RabchikEngineer/ValveController/PCB/ValveController.step

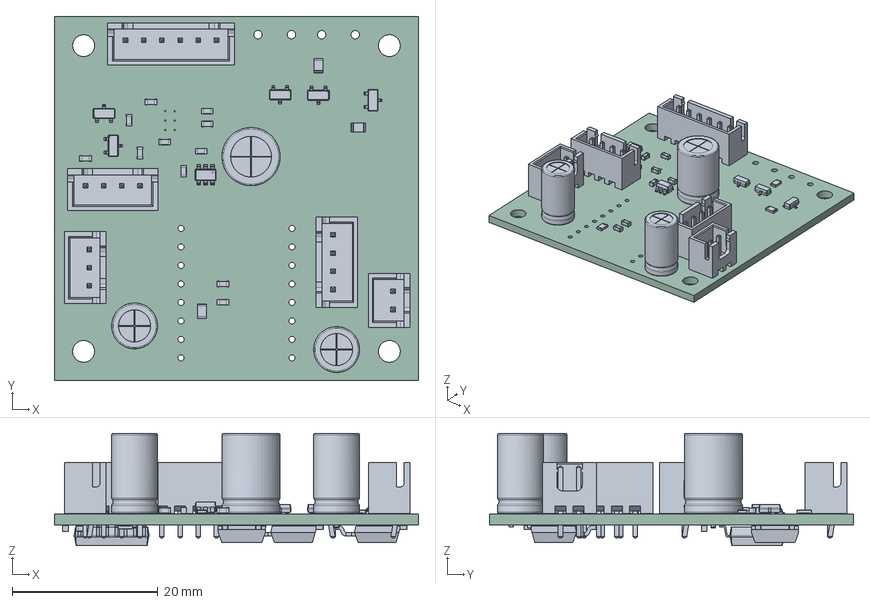
[picture p1: CAD file, 2025-12-08]
PCB/ValveController.step
50.0 x 50.0 x 15.4 mm
C_0603_1608Metric x 13
JST_XH_B4B-XH-A_1x04_P2.50mm_Vertical x 2
C_Radial_D6.3mm_H11.0mm_P2.50mm x 2
SOT-23 x 5
R_0805_2012Metric x 4
JST_XH_B3B-XH-A_1x03_P2.50mm_Vertical
C_Radial_D8.0mm_H11.5mm_P3.50mm
SOT-23-6
JST_XH_B6B-XH-A_1x06_P2.50mm_Vertical
JST_XH_B2B-XH-A_1x02_P2.50mm_Vertical
ValveController 1.29.1 x 3
SOIC-16W_7.5x10.3mm_P1.27mm
ValveController_PCB
