RabchikEngineer/ValveController/PCB/ValveController.kicad_pcb

## KiCad design PCB/ValveController.kicad_pcb (2025-12-16)

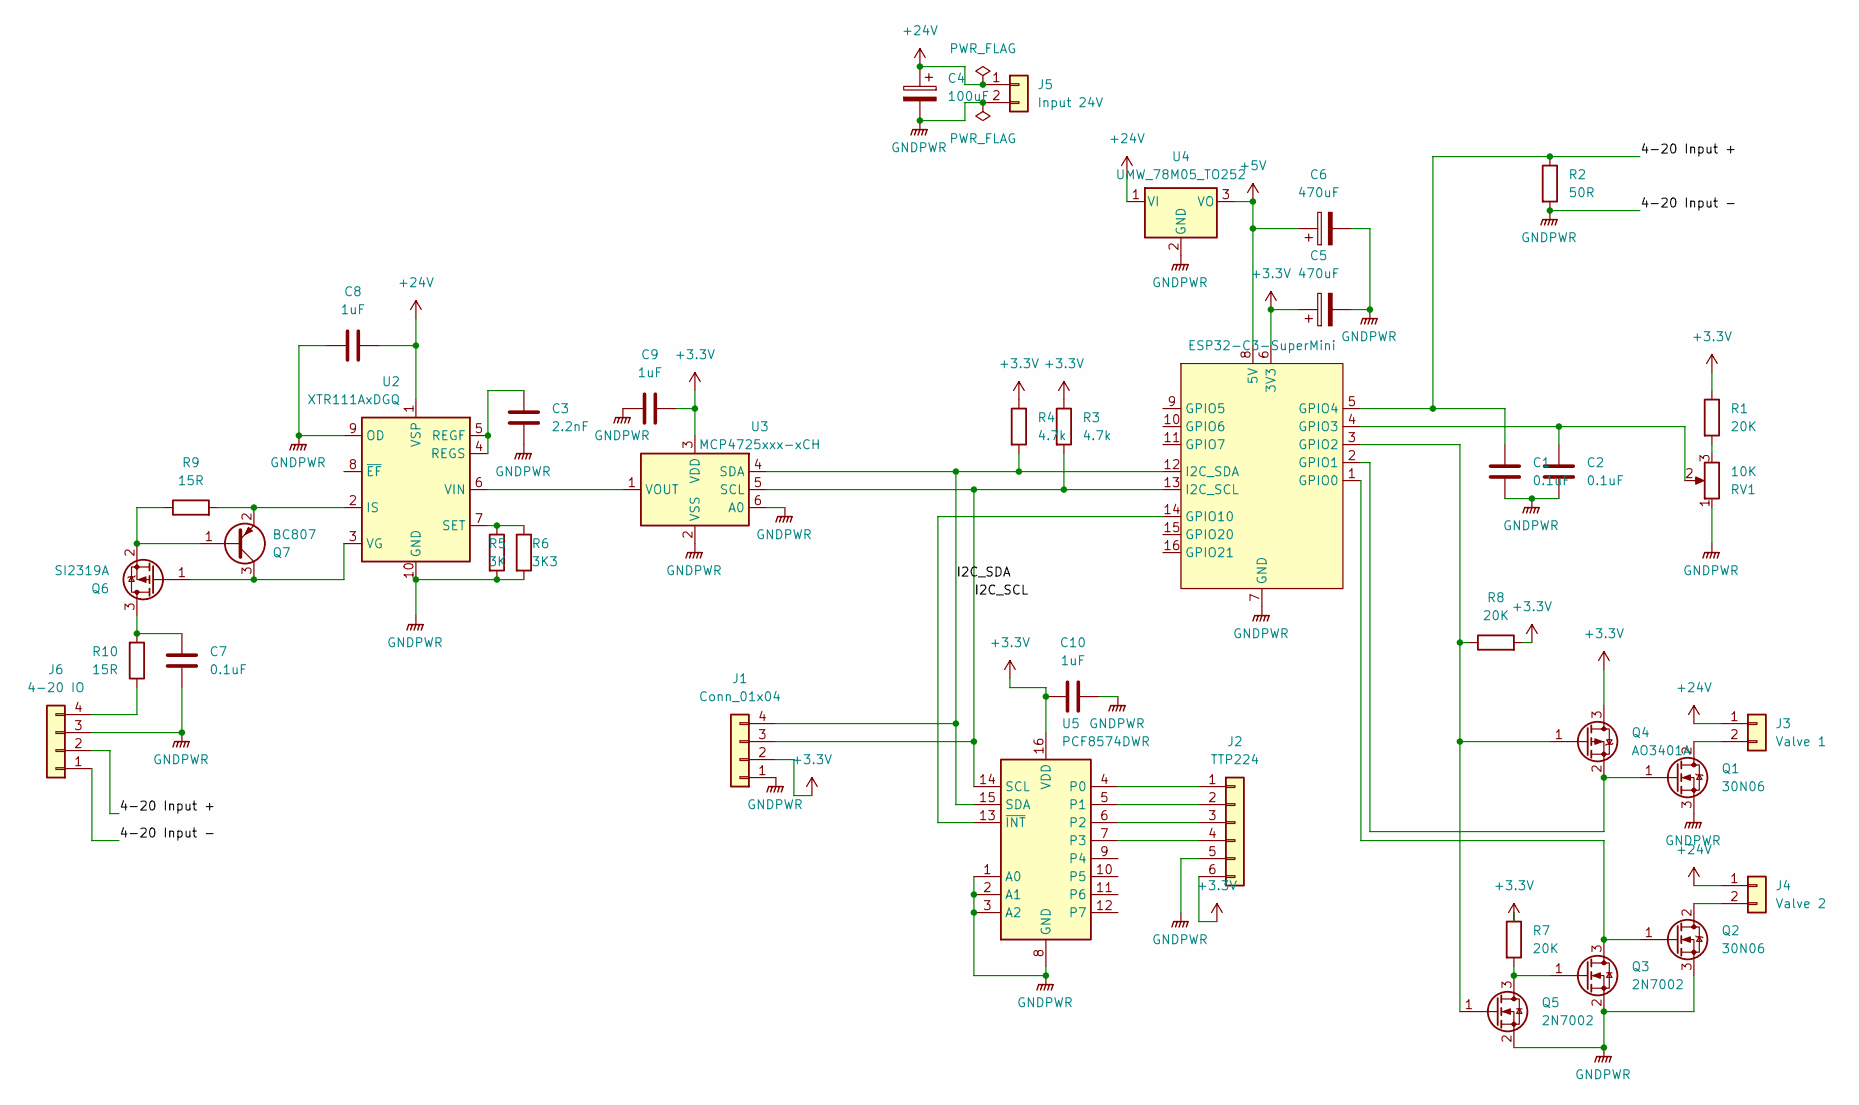
[picture p2: schematic ValveController.kicad_sch]

Parts:
C1, C2, C7: 0.1uF; C_0603_1608Metric_Pad1.08x0.95mm_HandSolder
C3: 2.2nF; C_0603_1608Metric_Pad1.08x0.95mm_HandSolder
C4: 100uF; C_Radial_D8.0mm_H11.5mm_P3.50mm
C5, C6: 470uF; C_Radial_D6.3mm_H11.0mm_P2.50mm
C8, C9, C10: 1uF; C_0603_1608Metric_Pad1.08x0.95mm_HandSolder
J1: Conn_01x04; JST_XH_B4B-XH-A_1x04_P2.50mm_Vertical
J2: TTP224; JST_XH_B6B-XH-A_1x06_P2.50mm_Vertical
J3: Valve 1; SolderWire-0.5sqmm_1x02_P4.6mm_D0.9mm_OD2.1mm
J4: Valve 2; SolderWire-0.5sqmm_1x02_P4.6mm_D0.9mm_OD2.1mm
J5: Input 24V; JST_XH_B2B-XH-A_1x02_P2.50mm_Vertical
J6: 4-20 IO; JST_XH_B4B-XH-A_1x04_P2.50mm_Vertical
Q1, Q2: 30N06; TO-252-2
Q3, Q5: 2N7002; SOT-23
Q4: AO3401A; SOT-23
Q6: SI2319A; SOT-23
Q7: BC807; SOT-23
R1, R7, R8: 20K; R_0805_2012Metric_Pad1.20x1.40mm_HandSolder
R2: 50R; R_0805_2012Metric_Pad1.20x1.40mm_HandSolder
R3, R4: 4.7k; C_0603_1608Metric_Pad1.08x0.95mm_HandSolder
R5: 3K; C_0603_1608Metric_Pad1.08x0.95mm_HandSolder
R6: 3K3; C_0603_1608Metric_Pad1.08x0.95mm_HandSolder
R9, R10: 15R; C_0603_1608Metric_Pad1.08x0.95mm_HandSolder
RV1: 10K; SolderWire-0.5sqmm_1x03_P4.6mm_D0.9mm_OD2.1mm
U1: ESP32-C3-SuperMini
U2: XTR111AxDGQ; MSOP-10-1EP_3x3mm_P0.5mm_EP2.2x3.1mm_Mask1.83x1.89mm_Therma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
U3: MCP4725xxx-xCH; SOT-23-6
U4: UMW_78M05_TO252; TO-252-2
U5: PCF8574DWR; SOIC-16W_7.5x10.3mm_P1.27mm

Connections:
+3.3V: C5.1, C9.2, C10.1, J1.2, J2.6, Q4.3 (D), R1.1, R3.1, R4.1, R7.1, R8.2, U1.6 (3V3), U3.3 (VDD), U5.16 (VDD)
+5V: C6.1, U1.8 (5V), U4.3 (VO)
+24V: C4.1, C8.2, J3.1, J4.1, J5.1, U2.1 (VSP), U4.1 (VI)
/4-20 Input +: C1.1, J6.2, R2.1, U1.5 (GPIO4)
/I2C_SCL: J1.3, R3.2, U1.13 (I2C_SCL), U3.5 (SCL), U5.14 (SCL)
/I2C_SDA: J1.4, R4.2, U1.12 (I2C_SDA), U3.4 (SDA), U5.15 (SDA)
GNDPWR: C1.2, C2.2, C3.2, C4.2, C5.2, C6.2, C7.2, C8.1, C9.1, C10.2, J1.1, J2.5, J5.2, J6.1, J6.3, Q1.3 (S), Q2.3 (S), Q3.2 (S), Q5.2 (S), R2.2, R5.2, R6.2, RV1.1, U1.7 (GND), U2.9 (OD), U2.10 (GND), U2.11 (GND), U3.2 (VSS), U3.6 (A0), U4.2 (GND), U5.1 (A0), U5.2 (A1), U5.3 (A2), U5.8 (GND)
unnamed: J2.1, U5.4 (P0)
unnamed: J2.2, U5.5 (P1)
unnamed: J2.3, U5.6 (P2)
unnamed: J2.4, U5.7 (P3)
unnamed: J3.2, Q1.2 (D)
unnamed: J4.2, Q2.2 (D)
unnamed: J6.4, R10.1
unnamed: Q1.1 (G), Q4.2 (S), U1.2 (GPIO1)
unnamed: Q2.1 (G), Q3.3 (D), U1.1 (GPIO0)
unnamed: Q3.1 (G), Q5.3 (D), R7.2
unnamed: Q4.1 (G), Q5.1 (G), R8.1, U1.3 (GPIO2)
unnamed: C7.1, Q6.3 (D), R10.2
unnamed: Q6.1 (G), Q7.3 (C), U2.3 (VG)
unnamed: Q6.2 (S), Q7.1 (B), R9.1
unnamed: Q7.2 (E), R9.2, U2.2 (IS)
unnamed: R1.2, RV1.3
unnamed: C2.1, RV1.2, U1.4 (GPIO3)
unnamed: U1.14 (GPIO10), U5.13 (~INT)
unnamed: C3.1, U2.4 (REGS), U2.5 (REGF)
unnamed: R5.1, R6.1, U2.7 (SET)
unnamed: U2.6 (VIN), U3.1 (VOUT)

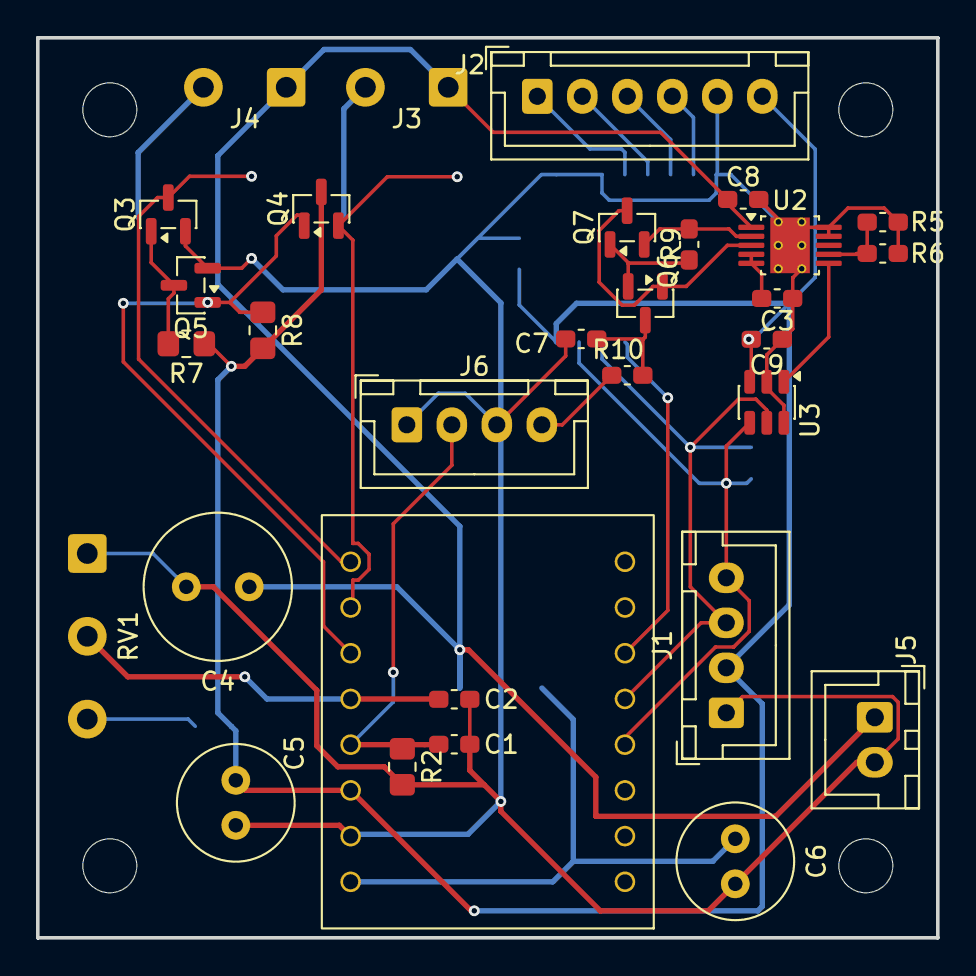
[picture p3: board ValveController.kicad_pcb from above]

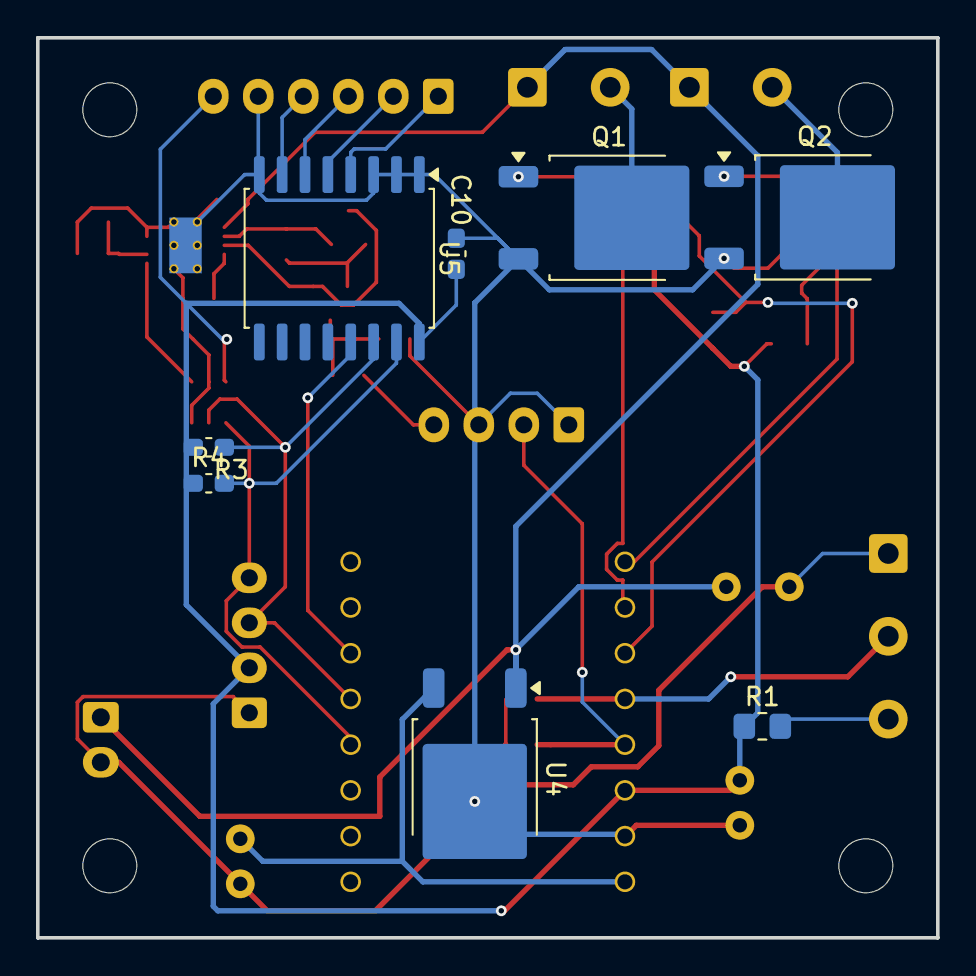
[picture p4: board ValveController.kicad_pcb from below]

Board: 2 copper layers, 50.0 x 50.0 mm, 39 parts (8 on the bottom side), 28 nets.
