RabchikEngineer/ValveController/ValveController_firmware/src/main.c

#include "esp_log.h"
#include "esp_timer.h"
#include "nvs_flash.h"
#include "cJSON.h"
#include "math.h"

//for serial communication
#include <stdio.h>
#include <string.h>

#include "freertos/FreeRTOS.h"
#include "freertos/task.h"
#include "freertos/queue.h"

#include "driver/gpio.h"
#include "driver/ledc.h"
#include "driver/i2c_master.h"
#include "driver/usb_serial_jtag.h"
#include "esp_lcd_panel_ops.h"
#include "esp_lcd_panel_io.h"
#include "esp_lcd_panel_vendor.h"


#include "config.h"
#include "adc.h"
#include "dac.h"
#include "usb_comm.h"
#include "params.h"
#include "buttons.h"
#include "ui.h"
#include "calibration.h"


const char *TAG_PID = "PID System";
const char *TAG_INPUT = "Input Handler";
const char *TAG_VALVE = "Valve Switcher";
const char *TAG_PWM = "PWM System";
// const char *TAG_ADC = "ADC";
static const char *TAG = "Main Thread";


typedef struct {
    float frequency;
    int resolution; 
} PWMConfig_t;

typedef struct {
    i2c_master_bus_handle_t bus;
    i2c_master_dev_handle_t pcf;
    i2c_master_dev_handle_t dac;
    esp_lcd_panel_handle_t  panel;
    esp_lcd_panel_io_handle_t panel_io;
} i2c_periphery_t;


QueueHandle_t inputQueue;
QueueHandle_t output_queue;


static i2c_periphery_t i2c_periphery;

static TaskHandle_t s_polling_task_handle;


volatile float valve_activation_threshold = 0.2; //for -1 --- 1 pid output



PWMConfig_t pwm_10_hz_config = {
    .frequency = 10,
    .resolution = 14
};

PWMConfig_t pwm_5_hz_config = {
    .frequency = 5,
    .resolution = 14
};

PWMConfig_t pwm_2_hz_config = {
    .frequency = 2,
    .resolution = 14
};

PWMConfig_t pwm_config;




void i2c_bus_init(i2c_master_bus_handle_t* bus)
{
     i2c_master_bus_config_t bus_cfg = {
        .i2c_port = I2C_PORT,
        .sda_io_num = I2C_SDA_GPIO,
        .scl_io_num = I2C_SCL_GPIO,
        .clk_source = I2C_CLK_SRC_DEFAULT,
        .glitch_ignore_cnt = 7,
        .flags.enable_internal_pullup = true, 
    };

    ESP_ERROR_CHECK(i2c_new_master_bus(&bus_cfg, bus));
    ESP_LOGI(TAG, "I2C bus init completed");
}

void i2c_bus_destroy(i2c_master_bus_handle_t bus)
{
    if (!bus) return;
    ESP_ERROR_CHECK(i2c_del_master_bus((i2c_master_bus_handle_t)bus));
    free(bus);
}

// void i2c_bus_remove_device(i2c_master_bus_handle_t bus, void *dev)
// {
//     (void)bus;
//     if (!dev) return;
//     ESP_ERROR_CHECK(i2c_master_bus_rm_device((i2c_master_dev_handle_t)dev));
// }

// int i2c_bus_probe(i2c_master_bus_handle_t bus, uint16_t addr_7bit, int timeout_ms)
// {
//     if (!bus) return -1;
//     return i2c_master_probe(bus, addr_7bit, timeout_ms);
// }


void i2c_periphery_init(i2c_periphery_t* i2c_periphery) {

    i2c_device_config_t dac_dev_cfg = {
        .dev_addr_length = I2C_ADDR_BIT_LEN_7,
        .device_address = MCP4725_I2C_ADDR,
        .scl_speed_hz = I2C_FREQ_HZ,
    };
    ESP_ERROR_CHECK(i2c_master_bus_add_device(i2c_periphery->bus, &dac_dev_cfg, &i2c_periphery->dac));


    i2c_device_config_t pcf_cfg = {
        .dev_addr_length = I2C_ADDR_BIT_LEN_7,
        .device_address = PCF8574DWR_I2C_ADDR,
        .scl_speed_hz = I2C_FREQ_HZ,
    };
    ESP_ERROR_CHECK(i2c_master_bus_add_device(i2c_periphery->bus, &pcf_cfg, &i2c_periphery->pcf));


    esp_lcd_panel_io_i2c_config_t panel_io_cfg = {
        .dev_addr = OLED_I2C_ADDR,
        .scl_speed_hz = I2C_FREQ_HZ,
        .control_phase_bytes = 1,
        .dc_bit_offset = 6,
        .lcd_cmd_bits = 8,
        .lcd_param_bits = 8,
    };
    ESP_ERROR_CHECK(esp_lcd_new_panel_io_i2c(i2c_periphery->bus, &panel_io_cfg, &i2c_periphery->panel_io));


    esp_lcd_panel_dev_config_t panel_cfg = {
        .bits_per_pixel = 1,
        .reset_gpio_num = OLED_RST_GPIO,
    };
    ESP_ERROR_CHECK(esp_lcd_new_panel_ssd1306(i2c_periphery->panel_io, &panel_cfg, &i2c_periphery->panel));


}






void valve_pwm_init(PWMConfig_t* config) {
    // Configure timer
    ledc_timer_config_t ledc_timer = {
        .speed_mode       = LEDC_LOW_SPEED_MODE,
        .duty_resolution  = config->resolution,
        .timer_num        = PWM_TIMER,
        .freq_hz          = config->frequency,
        .clk_cfg          = LEDC_USE_RC_FAST_CLK
    };
    ESP_ERROR_CHECK(ledc_timer_config(&ledc_timer));

    // Configure channel for INCREASE valve
    ledc_channel_config_t ledc_channel_inc = {
        .gpio_num       = VALVE_INC_PIN,
        .speed_mode     = LEDC_LOW_SPEED_MODE,
        .channel        = PWM_CHANNEL_INC,
        .intr_type      = LEDC_INTR_DISABLE,
        .timer_sel      = PWM_TIMER,
        .duty           = 0,  // Start at 0%
        .hpoint         = 0
    };
    ESP_ERROR_CHECK(ledc_channel_config(&ledc_channel_inc));

    ledc_channel_config_t ledc_channel_dec = {
        .gpio_num       = VALVE_DEC_PIN,
        .speed_mode     = LEDC_LOW_SPEED_MODE,
        .channel        = PWM_CHANNEL_DEC,
        .intr_type      = LEDC_INTR_DISABLE,
        .timer_sel      = PWM_TIMER,
        .duty           = 1,  // Start at 100%
        .hpoint         = 0
    };

    ESP_ERROR_CHECK(ledc_channel_config(&ledc_channel_dec));

    ESP_LOGI(TAG_VALVE, "PWM initialized: %d Hz, %d-bit resolution", 
             PWM_FREQUENCY, PWM_RESOLUTION);
}




void suspend_polling() {
    vTaskSuspend(s_polling_task_handle);
    ESP_LOGI(TAG, "Suspended polling task");
}

void resume_polling() {
    vTaskResume(s_polling_task_handle);
    ESP_LOGI(TAG, "Resumed polling task");
}


void polling_task() {
    ValvePositionData_t data;
    // TickType_t last_wake_time = xTaskGetTickCount();
    cl_set_output cl_val;
    while (1) {

        data = get_calibrated_adc_values();

        
        if (data.actualPositionPercent>1) {data.actualPositionPercent=1;}
        if (data.actualPositionPercent<0) {data.actualPositionPercent=0;}
        if (data.desiredPositionPercent>1) {data.desiredPositionPercent=1;}
        if (data.desiredPositionPercent<0) {data.desiredPositionPercent=0;}

        // data.desiredPositionPercent=(data.desiredPositionPercent-705)/(3590-705);
        // data.actualPositionPercent=(data.actualPositionPercent-1560)/(2480-1560);

        // Send to PID task
        xQueueSend(inputQueue, &data, 100);
        cl_val=(cl_set_output){.value=data.actualPositionPercent, .is_raw=false};
        xQueueSend(current_loop_queue, &cl_val, 100);

        // ESP_LOGI(TAG,"%d",(uint16_t)(data.actualPositionPercent*(1<<12)));
        // ESP_LOGI(TAG,"%d",((uint16_t)(data.actualPositionPercent*(1<<12)) & 0x0FFF));

        // ESP_LOGI(TAG, "Polled successfully");
        // xTaskDelayUntil(&last_wake_time,polling_delay); 
        vTaskDelay(pdMS_TO_TICKS(POLLING_DELAY));
    }
}



void PID_task() {
    ValvePositionData_t receivedData;
    
    float error = 0;
    float pid_output = 0;
    float integral = 0.0f;
    float prev_error = 0.0f;
    float dt=0.1f;
    int64_t last_time=0;
    float derivaitve_ema_alpha=0.8;
    float derivative = 0;

    // float Kp = 0.004f;
    // float Ki = 0.001f; // работают но с перелётом
    // float Kd = 0.002f;

    // float Kp = 2.0;
    // float Ki = 1.0;
    // float Kd = 2.0;

    while (1) {
        if (xQueueReceive(inputQueue, &receivedData, portMAX_DELAY) == pdPASS) {

            // controlOutput = PID_Compute(&pid, receivedData.desiredPositionPercent, receivedData.actualPositionPercent);
            error = receivedData.desiredPositionPercent - receivedData.actualPositionPercent;

            int64_t current_time = esp_timer_get_time();
            dt = (current_time - last_time) / 1000000.0f; // calculating actual dt. however it might differs only for 1%
            last_time=current_time;

            derivative = (derivative * (1- derivaitve_ema_alpha)) + ( (error - prev_error) / dt)*derivaitve_ema_alpha;
            prev_error = error;

            pid_output = ((g_config.kp * error) + (g_config.ki * integral) + (g_config.kd * derivative));

            bool saturated = (pid_output > 1.0f) || (pid_output < -1.0f);
            bool in_dead_zone = (fabsf(error) < g_config.deadzone); // doesnt calculate integral in small zone
            // Only integrate if not saturated
            if (!saturated && !in_dead_zone) {
                integral += error * dt;
                if (integral > 1.0f) integral = 1.0f; 
                if (integral < -1.0f) integral = -1.0f;
            } else if (saturated){
                // Decay integral slowly when can't actuate
                integral *= 0.95f;
            } else if (in_dead_zone){
                integral = 0;
                // pid_output=0;
            }

            if (isnan(pid_output)) {
                integral=0;
            }

            if (receivedData.desiredPositionPercent<0.01f) {
                pid_output=-1.0f;
            }
            if (receivedData.desiredPositionPercent>0.99f) {
                pid_output=1.0f;
            }


            // Convert controlOutput to command for valves
            // ESP_LOGI(TAG_PID, "Params P: %0.2f, I: %0.2f, D: %0.2f", g_config.kp, g_config.ki, g_config.kd);
            ESP_LOGI(TAG_PID, "A: %.3f/D: %.3f,I: %.3f , dt: %.5f, %.4f", 
                     receivedData.actualPositionPercent, receivedData.desiredPositionPercent, integral, dt, pid_output);
            // pid_output=0;
            xQueueSend(output_queue, &pid_output, 100);
        }
    }
}


void set_valve_pwm_task() {
    
    uint32_t max_duty = (1 << PWM_RESOLUTION) - 1;  // 1023 for 10-bit
    uint32_t duty_inc = 0;
    uint32_t duty_dec = 0;

    // TickType_t disabled_until = 0;

    float pid_output=0;
    
    while (1) {
        if (xQueueReceive(output_queue, &pid_output, portMAX_DELAY) == pdPASS) {


            if (fabsf(pid_output)<valve_activation_threshold) { // dead zone near center
                pid_output=0.0;
            } else if (pid_output+valve_activation_threshold>1.0) { // consider high values as 1
                pid_output=1.0;
            } else if (pid_output-valve_activation_threshold<-1.0) {
                pid_output=-1.0;
            }

            // if (pid_output>0) {pid_output=0.1;} else {pid_output=-0.1;}
            
            duty_inc = (uint32_t)(pid_output * max_duty);
            duty_dec = (uint32_t)(-pid_output * max_duty);

            
            // // Choose frequency based on required control precision
            // float abs_output = fabsf(pid_output);
            // if (abs_output > 0.5f) {
            // // Large error: fast response (10Hz)
            //     frequency = 10;
            // } else if (abs_output > 0.2f) {
            // // Medium error: balanced (5Hz)
            //     frequency = 5;
            // } else if (abs_output > 0.05f) {
            // // Small error: fine control (2Hz)
            //     frequency = 2;
            // } else {
            //     abs_output=0
            // }


            ESP_ERROR_CHECK(ledc_set_duty(LEDC_LOW_SPEED_MODE, PWM_CHANNEL_INC, duty_inc));
            ESP_ERROR_CHECK(ledc_update_duty(LEDC_LOW_SPEED_MODE, PWM_CHANNEL_INC));
            
            ESP_ERROR_CHECK(ledc_set_duty(LEDC_LOW_SPEED_MODE, PWM_CHANNEL_DEC, max_duty-duty_dec)); //inverting output max_duty-duty_dec
            ESP_ERROR_CHECK(ledc_update_duty(LEDC_LOW_SPEED_MODE, PWM_CHANNEL_DEC));
            
            // TickType_t now=xTaskGetTickCount();
            
            // if (now>disabled_until) {

            //     // Set PWM duty cycles
            //     ESP_ERROR_CHECK(ledc_set_duty(LEDC_LOW_SPEED_MODE, PWM_CHANNEL_INC, duty_inc));
            //     ESP_ERROR_CHECK(ledc_update_duty(LPOLLING_DELAYEDC_LOW_SPEED_MODE, PWM_CHANNEL_INC));
                
            //     ESP_ERROR_CHECK(ledc_set_duty(LEDC_LOW_SPEED_MODE, PWM_CHANNEL_DEC, max_duty-duty_dec)); //inverting output max_duty-duty_dec
            //     ESP_ERROR_CHECK(ledc_update_duty(LEDC_LOW_SPEED_MODE, PWM_CHANNEL_DEC));
                
            ESP_LOGD(TAG_VALVE, "PID: %.2f -> INC duty: %.2f, DEC duty: %.2f", 
                    pid_output, (float)duty_inc/max_duty, (float)duty_dec/max_duty);
                
            //     disabled_until=now+pdMS_TO_TICKS(VALVE_IDLE_DELAY);
            // }
        }
    }

    
}




void app_main(void)
{   
    
    // vTaskDelay(pdMS_TO_TICKS(5000));


    ESP_LOGI(TAG,"Starting program");

    inputQueue = xQueueCreate(2, sizeof(ValvePositionData_t));
    output_queue = xQueueCreate(2, sizeof(float));

    nvs_init();
    config_load();
    calibration_load();

    // printf("Current PID: %.6f %.6f %.6f\n", g_config.kp, g_config.ki, g_config.kd);

    // data_point_t* points[] = {{1,2},{2,4}};
    // // ApproxPoly_t input_approx = {3,points};
    // ApproxPoly_t input_approx = {
    // .num_points = 2,
    // .points = points
    // };

    // for (int i=0; i<2; i++) {

    //     printf("%f",input_approx.points[i]);

    // }



    


    i2c_bus_init(&i2c_periphery.bus);
    i2c_periphery_init(&i2c_periphery);
    ESP_LOGI(TAG,"I2C init completed");

    bool i2c_devices_ok=false;
    while (!i2c_devices_ok) {
        i2c_devices_ok = true;
        if (i2c_master_probe(i2c_periphery.bus, OLED_I2C_ADDR, I2C_RESPONSE_TIMEOUT_MS)!=ESP_OK) {
            ESP_LOGE(TAG, "Panel doesn't responding");
            i2c_devices_ok=false;
        }
        if (i2c_master_probe(i2c_periphery.bus, MCP4725_I2C_ADDR, I2C_RESPONSE_TIMEOUT_MS)!=ESP_OK) {
            ESP_LOGE(TAG, "DAC doesn't responding");
            i2c_devices_ok=false;
        }
        if (i2c_master_probe(i2c_periphery.bus, PCF8574DWR_I2C_ADDR, I2C_RESPONSE_TIMEOUT_MS)!=ESP_OK) {
            ESP_LOGE(TAG, "PCF doesnt responding");
            i2c_devices_ok=false;
        }
        if (!i2c_devices_ok) {vTaskDelay(pdMS_TO_TICKS(1000));}

    }

    pwm_config = pwm_10_hz_config;
    pwm_config.frequency = g_config.pwm_freq_hz;


    valve_pwm_init(&pwm_config);
    ESP_LOGI(TAG, "PWM configured");

    // set 21 gpio to high
    gpio_config_t io_conf = {
        .pin_bit_mask = (1ULL << 21),     
        .mode = GPIO_MODE_OUTPUT,            // Set as output
        .pull_up_en = GPIO_PULLUP_DISABLE,  // Disable pull-up
        .pull_down_en = GPIO_PULLDOWN_DISABLE,  // Disable pull-down
        .intr_type = GPIO_INTR_DISABLE             // Disable interrupts
    };
    gpio_config(&io_conf);
    gpio_set_level(21,1);  //safety logic disable

    
    usb_comm_init();
    ESP_LOGI(TAG, "USB input configured");


    ESP_LOGI(TAG, "Starting tasks...");
    
    adc_start();

    current_loop_init(i2c_periphery.dac);

    

    TaskHandle_t* read_buttons_task_handler = button_reader_init(i2c_periphery.pcf);
    
    xTaskCreate(adc_continuous_read_task, "adc_read_task",            8192, NULL, 9, NULL);
    xTaskCreate(polling_task,             "polling_task",             2048, NULL, 7, &s_polling_task_handle);
    xTaskCreate(PID_task,                 "PID_task",                 4096, NULL, 8, NULL);
    xTaskCreate(set_valve_pwm_task,       "set_valve_pwm_task",       2048, NULL, 9, NULL);
    xTaskCreate(usb_input_task,           "usb_input_task",           4096, NULL, 5, NULL);
    xTaskCreate(current_loop_output_task, "cl_output_task",           4096, NULL, 9, NULL);
    xTaskCreate(read_buttons_task,        "read_buttons_task",        2048, NULL, 7, read_buttons_task_handler);

    calibration_init(output_queue);
    xTaskCreate(calibration_task, "calibration_task", 4096, NULL, 8, NULL);


    button_reader_install_isr(10);

    ui_init(i2c_periphery.panel);
    xTaskCreate((TaskFunction_t)ui_run, "ui", 4096, NULL, 5, NULL);
    

    ESP_LOGI(TAG, "Tasks started...");

    // char testbuf[1000]={};

    // while (1) {
    //     vTaskGetRunTimeStats(testbuf);

    //     ESP_LOGI(TAG, "%s",testbuf);

    //     vTaskDelay(pdMS_TO_TICKS(10000));
    // }
        


    
    

    


   





    

}
