RabchikEngineer/ValveController/(commit log)

2025-11-09 Continous adc measurement
2025-11-09 Added pwm for valves, increaced precision via PID
2025-11-17 PID coeff can be setted via usb
2025-12-03 Include PCB project
    [ValveController.kicad_pcb, ValveController.kicad_sch, ValveController.step]
2025-12-08 Scheme and PCB updates
    [ValveController.kicad_pcb, ValveController.kicad_sch, ValveController.step]
2025-12-13 Backup before refactoring
    [ValveController.kicad_pcb]
2026-03-13 UI v1.0 + calibration testing
2026-03-28 Valve V1.1 improved ui, added calibration
2026-04-01 Valve v1.1.1
